THEarmpit/OSSM-Designs/README.md

# Primary project: [PitClamp v3](https://github.com/THEarmpit/OSSM-Designs/blob/main/PitClamp%20v3)

[More details for other projects coming soon]
