THEarmpit/OSSM-Designs/OSSM Remote Knobs/README.md

## OSSM Remote Knobs

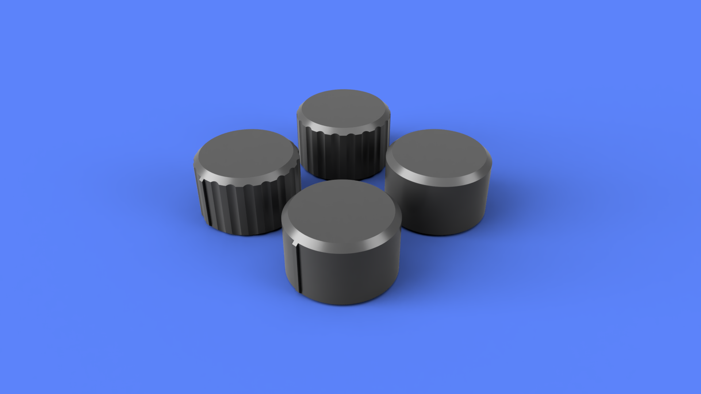
[picture p1: OSSM Remote Knobs/Images/armpit_OSSM_Remote_Knobs.png]
OSSM Remote Knobs
  

**Summary**  
Knobs that have the same overall footprint as OSSM default, but have a more minimal design providing a more easily sanitized surface and easier adjustments

- Grooved With Position Indicator  
- Grooved Simple  
- Smooth With Position Indicator  
- Smooth Simple  

**Printing**  
Print with support and with top surface ironing enabled
