THEarmpit/OSSM-Designs/Remote Mount/README.md

**To contain:**  
OSSM Remote Mount  
OSSM Remote Mount 2Part
