THEarmpit/OSSM-Designs/PitClamp v3/Base - 4040/Images/Clamped_With_Baseplate.png

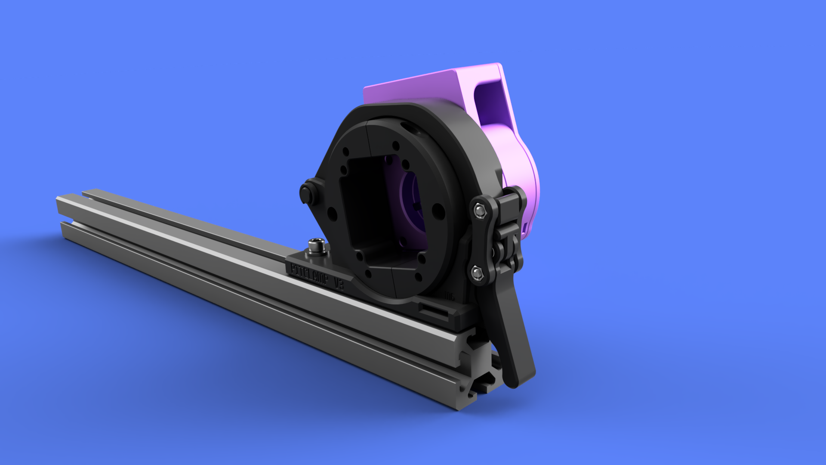
PitClamp v3/Base - 4040/Images/Clamped_With_Baseplate.png
