THEarmpit/OSSM-Designs/PitClamp v3/Base - 4040/Images/SupportSettings.png

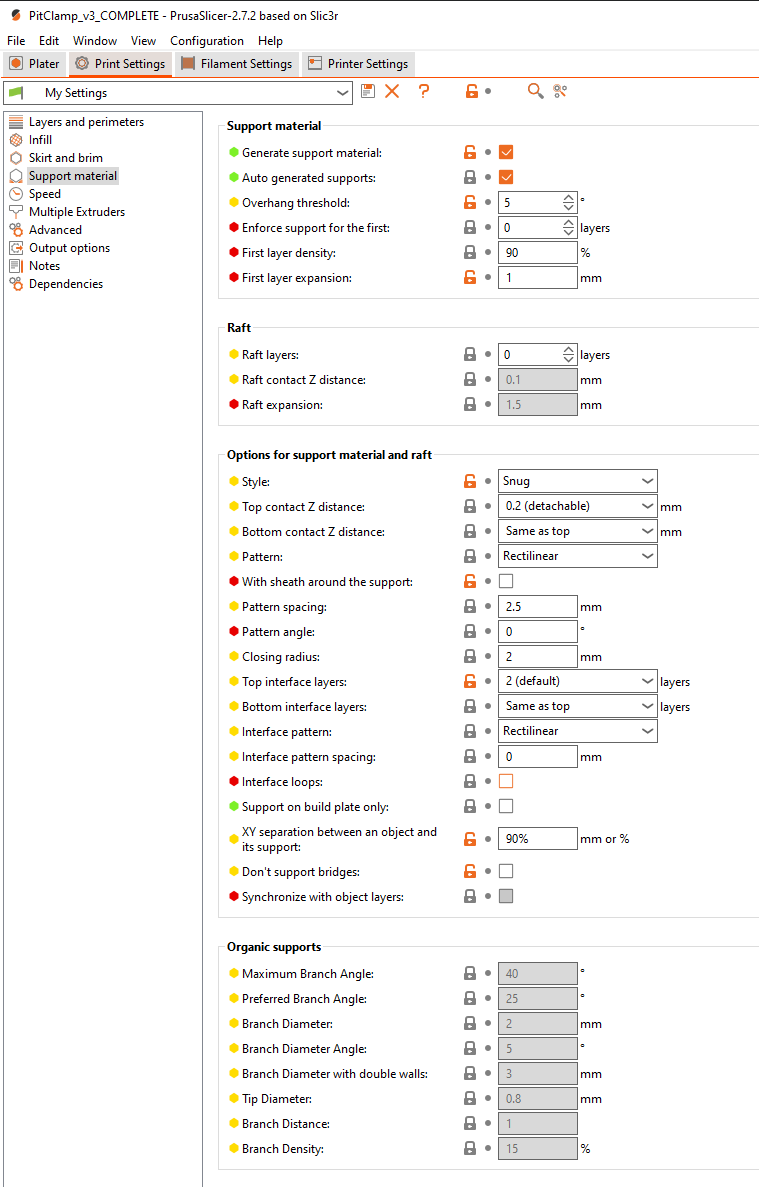
PitClamp v3/Base - 4040/Images/SupportSettings.png
