THEarmpit/OSSM-Designs/PitClamp v3/Images/PitClamp_v3_Closed_WithMotor.png

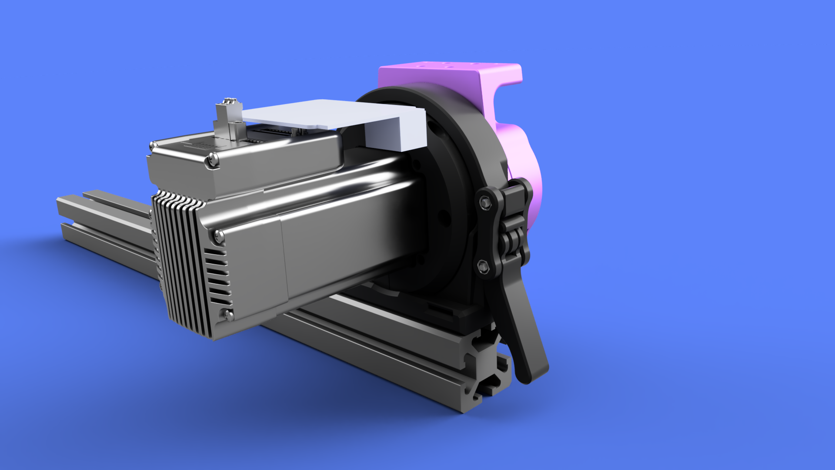
PitClamp v3/Images/PitClamp_v3_Closed_WithMotor.png
