THEarmpit/OSSM-Designs/4040 Components/README.md

**To contain:**  
Clamp Handle Lever  
Hinge Plate 210deg  
Hinge Plate 300deg  
Hinge Plate Nuts  
Mean Well GST120A24-P1M PSU Mounting Bracket  
Weight Bracket
