THEarmpit/OSSM-Designs/PitClamp v3/Base - Tabletop/Images/PitClamp_v3_Tabletop_Parts.png

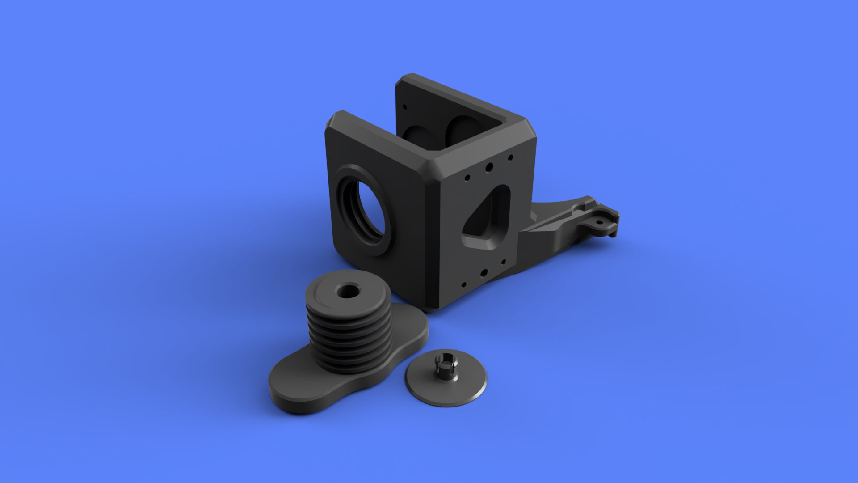
PitClamp v3/Base - Tabletop/Images/PitClamp_v3_Tabletop_Parts.png
