THEarmpit/OSSM-Designs/OSSM Reference PCB Housing With Strain Relief/Release Files/STEP/OSSM_Reference_PCB_Housing_V2_StrainRelief_Top_Reinforced_Widened_RC1.step

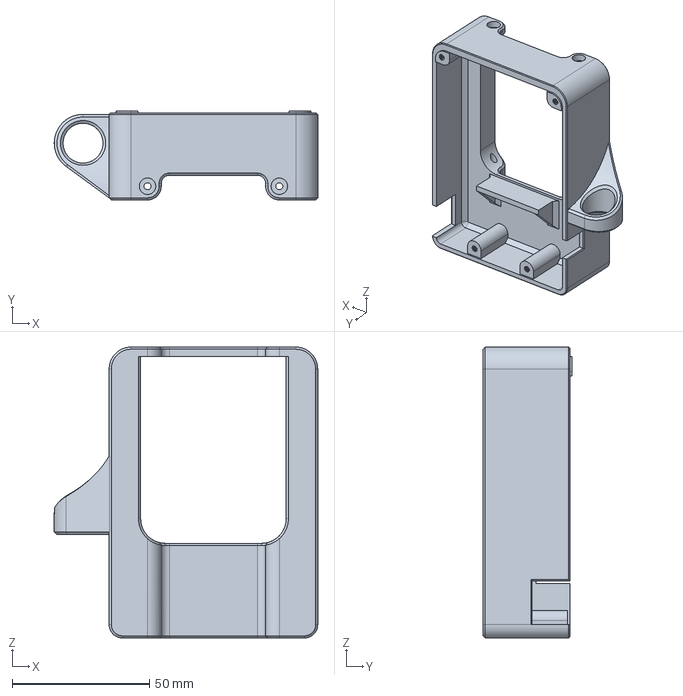
[picture p22: CAD file, 2024-06-19]
OSSM Reference PCB Housing With Strain Relief/Release Files/STEP/OSSM_Reference_PCB_Housing_V2_StrainRelief_Top_Reinforced_Widened_RC1.step
96.0 x 32.4 x 106.0 mm
