THEarmpit/OSSM-Designs/OSSM Remote Knobs/Release Files/armpit_OSSM_Remote_Knob_Smooth_With_Indicator.stl

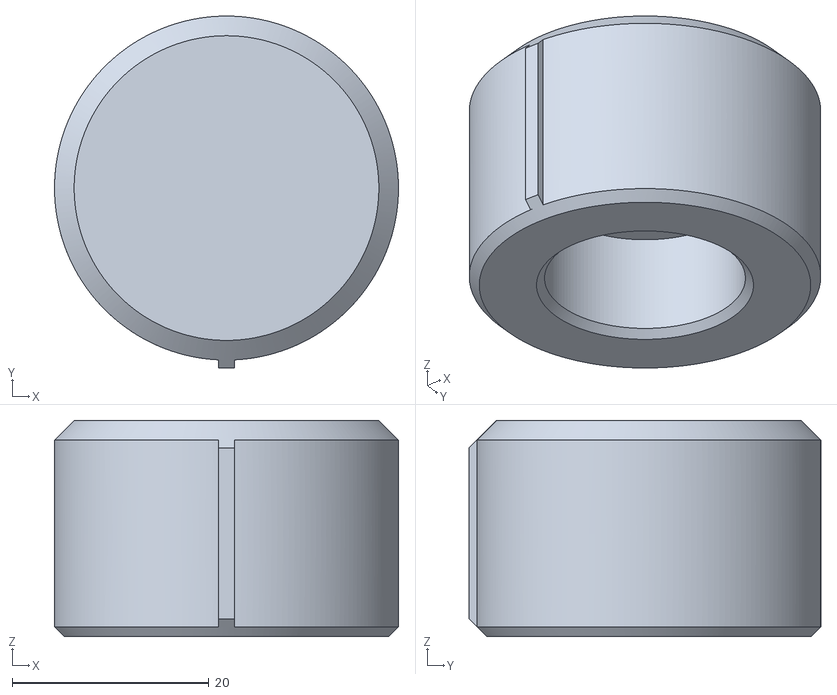
[picture p23: CAD file, 2024-06-19]
OSSM Remote Knobs/Release Files/armpit_OSSM_Remote_Knob_Smooth_With_Indicator.stl
35.0 x 35.8 x 22.0
