THEarmpit/OSSM-Designs/OSSM Remote Mount/Release Files/STEP/armpit_OSSM_Remote_Mount_2Part_Bottom.step

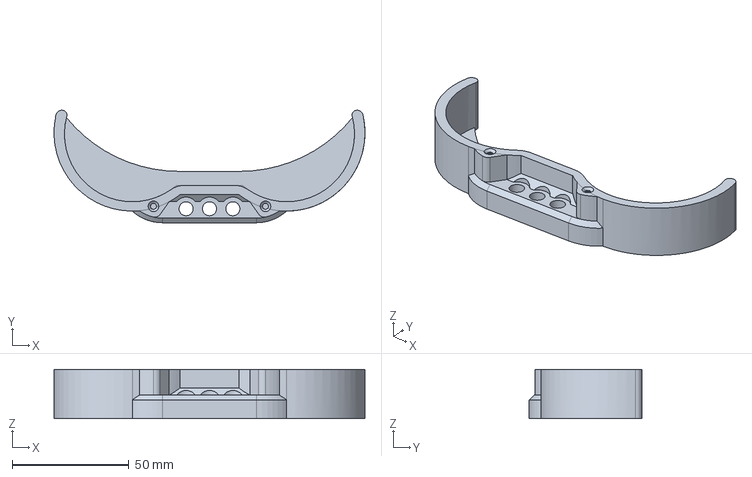
[picture p24: CAD file, 2024-06-19]
OSSM Remote Mount/Release Files/STEP/armpit_OSSM_Remote_Mount_2Part_Bottom.step
132.9 x 48.1 x 21.0 mm
