THEarmpit/OSSM-Designs/PitClamp v3/Base - 4040/Release Files/PitClamp_v3_Ring_Base_M8.stl

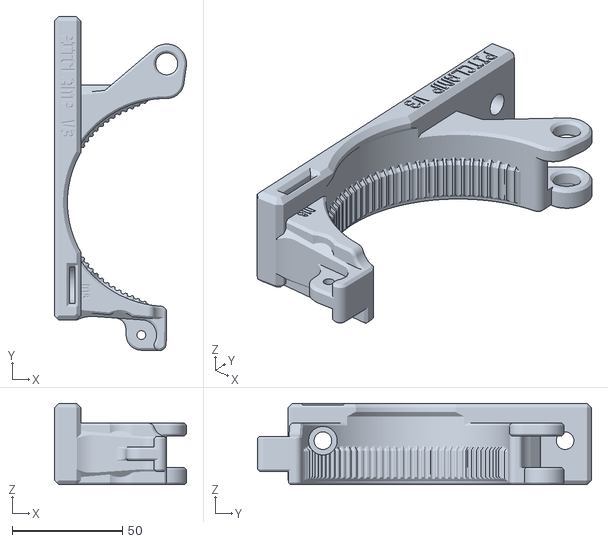
[picture p25: CAD file, 2024-03-31]
PitClamp v3/Base - 4040/Release Files/PitClamp_v3_Ring_Base_M8.stl
60.0 x 151.7 x 37.0
