THEarmpit/OSSM-Designs/PitClamp v3/Motor Rings/Release Files/STEP/PitClamp_v3_Motor_Ring_Half_EXTRAGRIP_140w.step

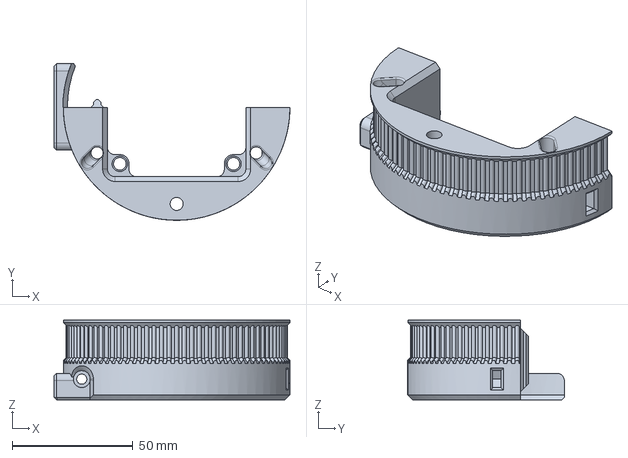
[picture p26: CAD file, 2024-04-06]
PitClamp v3/Motor Rings/Release Files/STEP/PitClamp_v3_Motor_Ring_Half_EXTRAGRIP_140w.step
97.9 x 64.9 x 33.0 mm
