THEarmpit/OSSM-Designs/PitClamp v3/Shared Components/Non-standard/20-4040/PitClamp_v3_Ring_Base_M5.stp

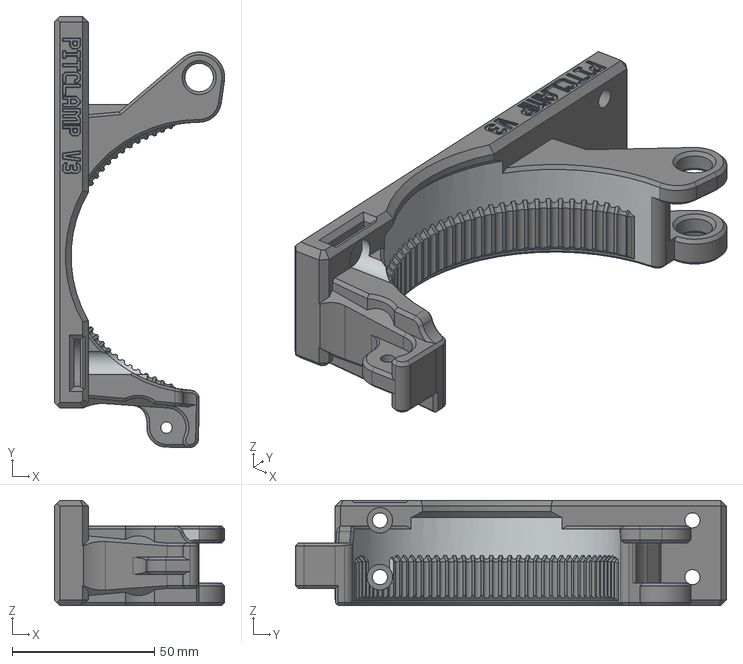
[picture p27: CAD file, 2024-04-24]
PitClamp v3/Shared Components/Non-standard/20-4040/PitClamp_v3_Ring_Base_M5.stp
60.0 x 151.7 x 37.0 mm
