THEarmpit/OSSM-Designs/PitClamp v3/Shared Components/Non-standard/dbiesn Head/PitClamp_v3_Motor_Ring_Half_EXTRAGRIP_dbiesn_head.step

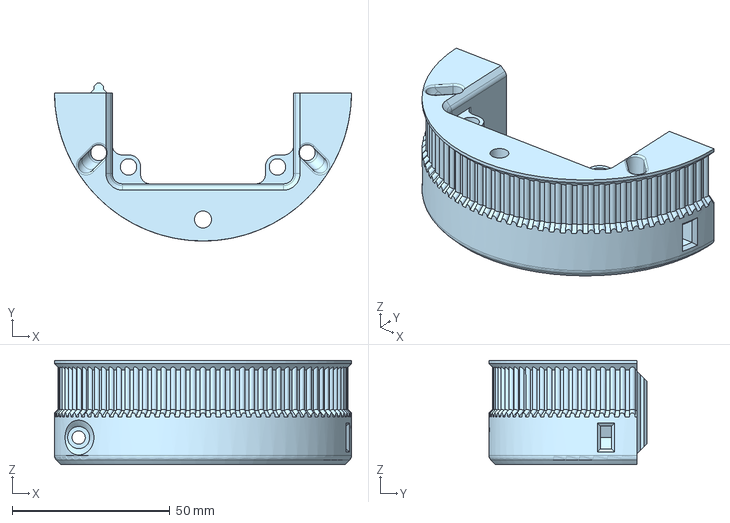
[picture p28: CAD file, 2024-04-24]
PitClamp v3/Shared Components/Non-standard/dbiesn Head/PitClamp_v3_Motor_Ring_Half_EXTRAGRIP_dbiesn_head.step
94.0 x 50.0 x 33.0 mm
