THEarmpit/OSSM-Designs/PitClamp v3/Shared Components/Non-standard/Handles/PitClamp_v3_Handle_Forward.step

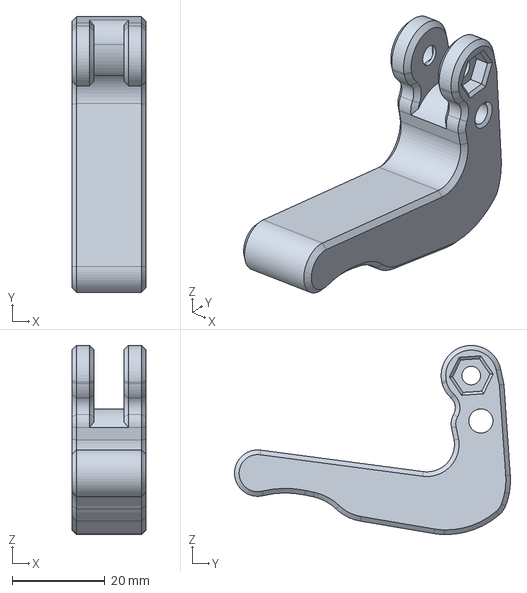
[picture p29: CAD file, 2024-04-15]
PitClamp v3/Shared Components/Non-standard/Handles/PitClamp_v3_Handle_Forward.step
16.0 x 59.5 x 40.8 mm
