THEarmpit/OSSM-Designs/PitClamp v3/Shared Components/Non-standard/Motor Ring Tighter/PitClamp_v3_Motor_Ring_Half_Tighter_Tolerances.step

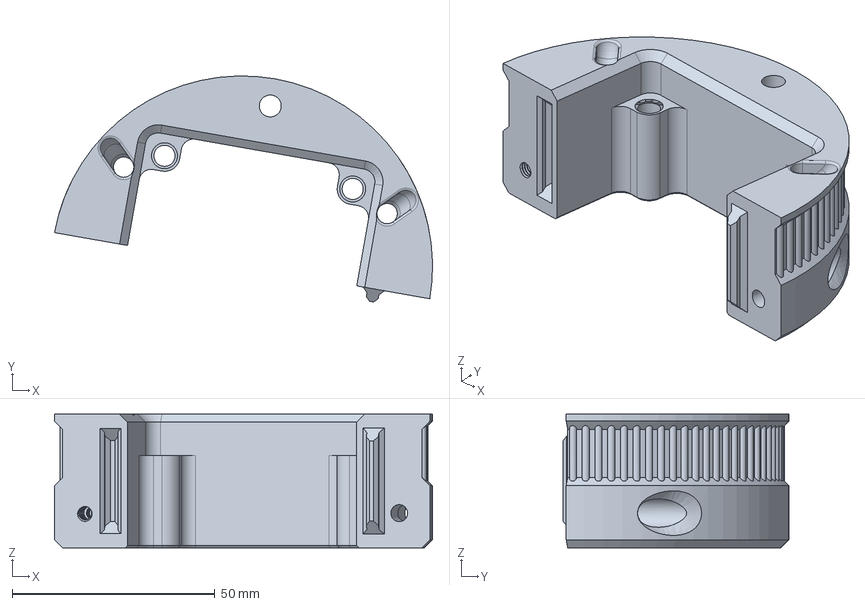
[picture p30: CAD file, 2024-05-07]
PitClamp v3/Shared Components/Non-standard/Motor Ring Tighter/PitClamp_v3_Motor_Ring_Half_Tighter_Tolerances.step
93.2 x 55.8 x 33.0 mm
