THEarmpit/OSSM-Designs/PitClamp v3/Shared Components/Non-standard/Shortened Dogbones/PitClamp_v3_Dogbone_Nuts_29mm.step

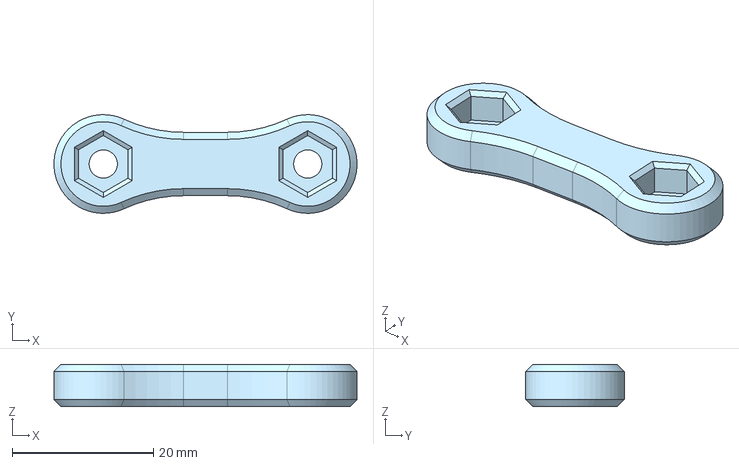
[picture p31: CAD file, 2024-04-24]
PitClamp v3/Shared Components/Non-standard/Shortened Dogbones/PitClamp_v3_Dogbone_Nuts_29mm.step
43.0 x 14.0 x 6.00 mm
