THEarmpit/OSSM-Designs/PitClamp v3/Shared Components/Release Files/PitClamp_v3_Handle_Forward.stl

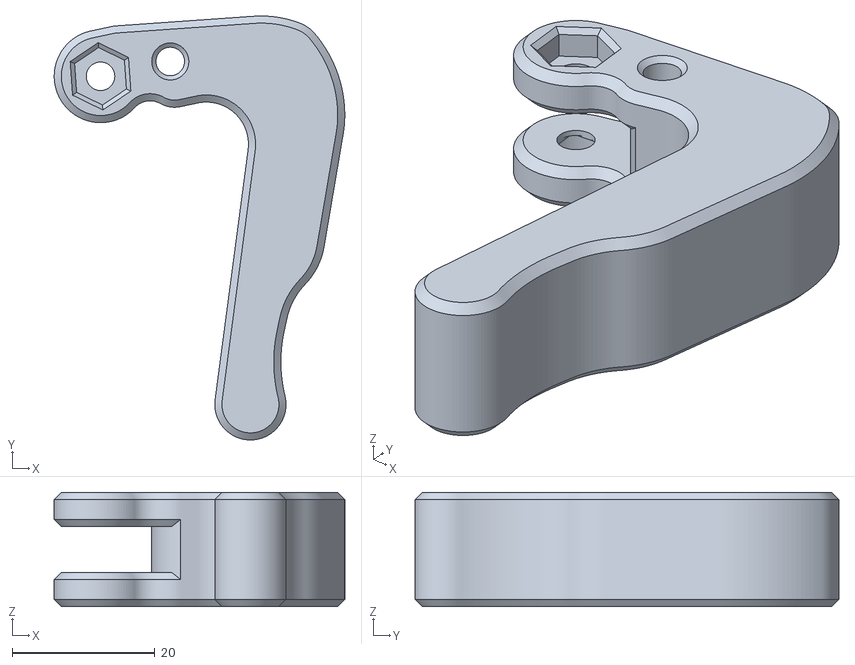
[picture p32: CAD file, 2024-04-15]
PitClamp v3/Shared Components/Release Files/PitClamp_v3_Handle_Forward.stl
40.8 x 59.5 x 16.0
