THEarmpit/OSSM-Designs/PitClamp v3/Shared Components/Release Files/STEP/PitClamp_v3_Handle.step

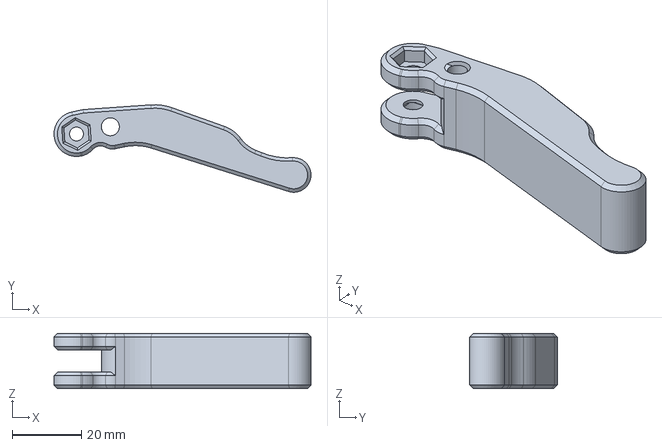
[picture p33: CAD file, 2024-03-31]
PitClamp v3/Shared Components/Release Files/STEP/PitClamp_v3_Handle.step
74.2 x 25.3 x 16.0 mm
