THEarmpit/OSSM-Designs/OSSM Remote Knobs/Release Files/armpit_OSSM_Remote_Knob_Smooth_Simple.stl

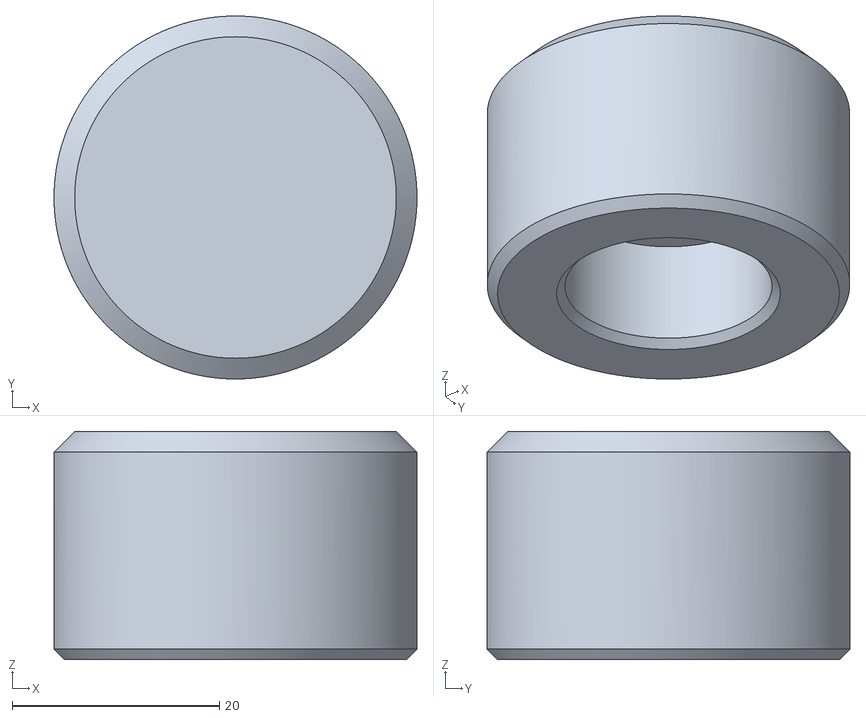
[picture p35: CAD file, 2024-06-19]
OSSM Remote Knobs/Release Files/armpit_OSSM_Remote_Knob_Smooth_Simple.stl
35.0 x 35.0 x 22.0
