THEarmpit/OSSM-Designs/OSSM Remote Mount/Release Files/STEP/armpit_OSSM_Remote_Mount_2Part_Top.step

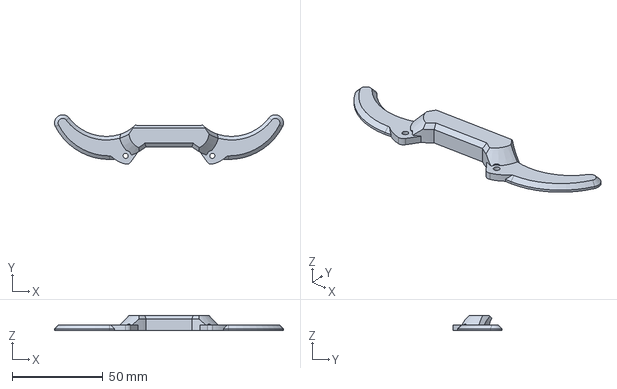
[picture p36: CAD file, 2024-06-19]
OSSM Remote Mount/Release Files/STEP/armpit_OSSM_Remote_Mount_2Part_Top.step
126.5 x 27.3 x 8.40 mm
