THEarmpit/OSSM-Designs/PitClamp v3/Shared Components/Release Files/STEP/PitClamp_v3_Hinge_Pin_Clip.step

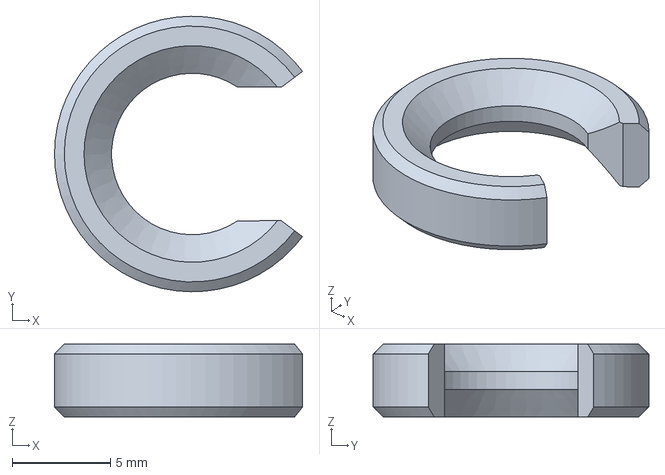
[picture p37: CAD file, 2024-03-31]
PitClamp v3/Shared Components/Release Files/STEP/PitClamp_v3_Hinge_Pin_Clip.step
12.6 x 14.0 x 3.70 mm
