THEarmpit/OSSM-Designs/PitClamp v3/Shared Components/Release Files/STEP/PitClamp_v3_Ring_Upper.step

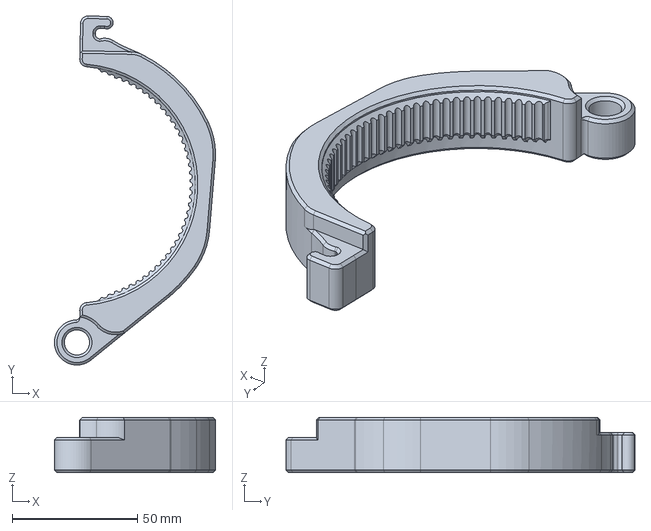
[picture p38: CAD file, 2024-03-31]
PitClamp v3/Shared Components/Release Files/STEP/PitClamp_v3_Ring_Upper.step
64.3 x 139.2 x 22.0 mm
