THEarmpit/OSSM-Designs/PitClamp v3/Shared Components/Release Files/STEP/PitClamp_v3_Dogbone_Nuts.step

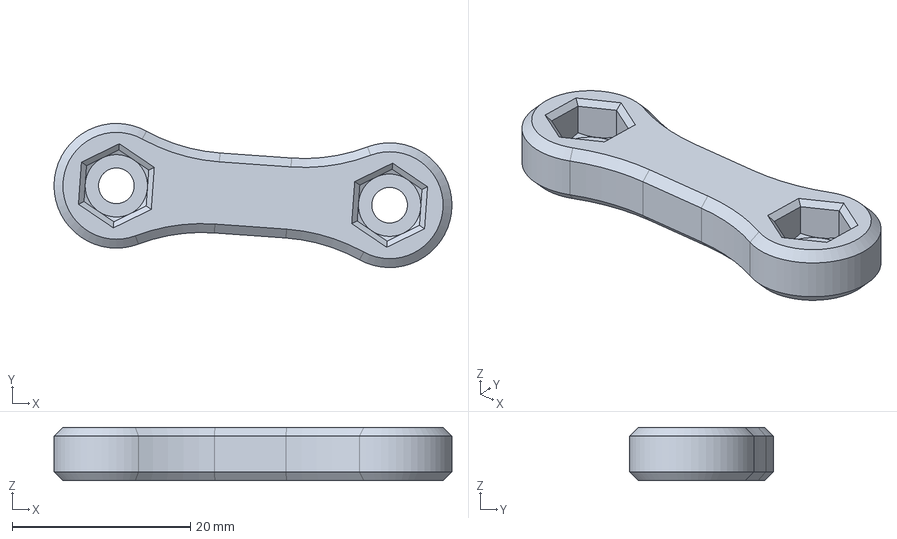
[picture p39: CAD file, 2024-03-31]
PitClamp v3/Shared Components/Release Files/STEP/PitClamp_v3_Dogbone_Nuts.step
44.7 x 16.2 x 6.00 mm
