THEarmpit/OSSM-Designs/PitClamp v3/Shared Components/Release Files/STEP/PitClamp_v3_Hinge_Pin.step

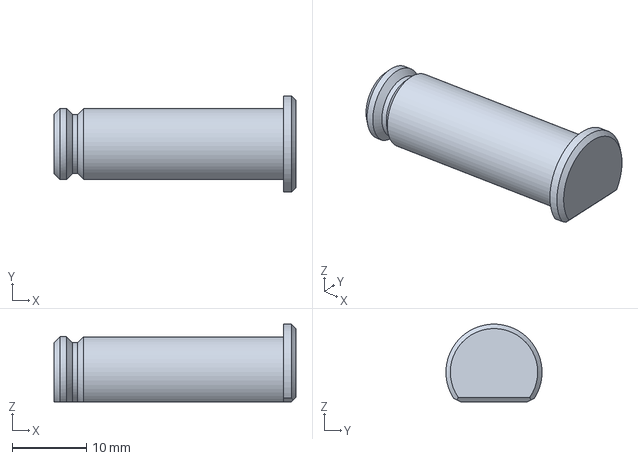
[picture p40: CAD file, 2024-03-31]
PitClamp v3/Shared Components/Release Files/STEP/PitClamp_v3_Hinge_Pin.step
32.7 x 13.0 x 10.5 mm
