THEarmpit/OSSM-Designs/(list of files, cad)

Other CAD files:
PitClamp v3/Base - 4040/Release Files/STEP/PitClamp_v3_Ring_Base_M6.step
PitClamp v3/Base - Tabletop/Release Files/STEP/PitClamp_v3_Tabletop_Mount.step
PitClamp v3/Motor Rings/Release Files/STEP/PitClamp_v3_Motor_Ring_Half_140w.step
OSSM Remote Knobs/Release Files/armpit_OSSM_Remote_Knob_Grooved_With_Indicator.stl
PitClamp v3/Motor Rings/Release Files/STEP/PitClamp_v3_Motor_Ring_Half_EXTRAGRIP.step
OSSM Remote Knobs/Release Files/armpit_OSSM_Remote_Knob_Grooved_Simple.stl
PitClamp v3/Motor Rings/Release Files/STEP/PitClamp_v3_Motor_Ring_Half.step
OSSM Reference PCB Housing With Strain Relief/Release Files/OSSM_Reference_PCB_Housing_V2_StrainRelief_Bottom_Reinforced_Widened_RC1.stl
OSSM Reference PCB Housing With Strain Relief/Release Files/OSSM_Reference_PCB_Housing_V2_StrainRelief_Top_Reinforced_Widened_RC1.stl
OSSM Remote Mount/Legacy Files/armpit_OSSM_Remote_Mount.stl
OSSM Remote Mount/Legacy Files/armpit_OSSM_Remote_Mount_Reinforced.stl.stl
OSSM Remote Mount/Release Files/armpit_OSSM_Remote_Mount_2Part_Bottom.stl
OSSM Remote Mount/Release Files/armpit_OSSM_Remote_Mount_2Part_Top.stl
PitClamp Mini/Screwcap Mini Tensioner/Release Files/STEP/Screwcap_Mini_Tensioner_Base_RC1.step
PitClamp Mini/Screwcap Mini Tensioner/Release Files/STEP/Screwcap_Mini_Tensioner_Cap_RC1.step
PitClamp Mini/Screwcap Mini Tensioner/Release Files/STEP/Screwcap_Mini_Tensioner_Ring_RC1.step
PitClamp Mini/Screwcap Mini Tensioner/Release Files/Screwcap_Mini_Tensioner_Base_RC1.stl
PitClamp Mini/Screwcap Mini Tensioner/Release Files/Screwcap_Mini_Tensioner_Cap_RC1.stl
PitClamp Mini/Screwcap Mini Tensioner/Release Files/Screwcap_Mini_Tensioner_RC1.3mf
PitClamp Mini/Screwcap Mini Tensioner/Release Files/Screwcap_Mini_Tensioner_Ring_RC1.stl
PitClamp v3/Base - 4040/Release Files/PitClamp_v3_Ring_Base_M6.stl
PitClamp v3/Base - Tabletop/Release Files/PitClamp_v3_Tabletop_Screw.stl
PitClamp v3/Base - Tabletop/Release Files/PitClamp_v3_Tabletop_Screw_Topper.stl
PitClamp v3/Base - Tabletop/Release Files/STEP/PitClamp_v3_Tabletop_Screw.step
PitClamp v3/Base - Tabletop/Release Files/STEP/PitClamp_v3_Tabletop_Screw_Topper.step
PitClamp v3/Motor Rings/Release Files/PitClamp_v3_Motor_Ring_Half.stl
PitClamp v3/Motor Rings/Release Files/PitClamp_v3_Motor_Ring_Half_140w.stl
PitClamp v3/Motor Rings/Release Files/PitClamp_v3_Motor_Ring_Half_EXTRAGRIP.stl
PitClamp v3/Motor Rings/Release Files/PitClamp_v3_Motor_Ring_Half_EXTRAGRIP_140w.stl
PitClamp v3/Shared Components/Non-standard/20-4040/PitClamp_v3_Ring_Base_M5.stl
PitClamp v3/Shared Components/Non-standard/Motor Ring Tighter/PitClamp_v3_Motor_Ring_Half_Tighter_Tolerances.stl
PitClamp v3/Shared Components/Non-standard/Shortened Dogbones/PitClamp_v3_Dogbone_Bolts_29mm.step
PitClamp v3/Shared Components/Release Files/PitClamp_V3_Ring_Upper.stl
PitClamp v3/Shared Components/Release Files/PitClamp_v3_Dogbone_Bolts.stl
PitClamp v3/Shared Components/Release Files/PitClamp_v3_Dogbone_Nuts.stl
PitClamp v3/Shared Components/Release Files/PitClamp_v3_Handle.stl
PitClamp v3/Shared Components/Release Files/PitClamp_v3_Hinge_Pin.stl
PitClamp v3/Shared Components/Release Files/PitClamp_v3_Hinge_Pin_Clip.stl
PitClamp v3/Shared Components/Release Files/STEP/PitClamp_v3_Dogbone_Bolts.step
