THEarmpit/OSSM-Designs/(commit log)

2024-03-31 Rename PitClamp v3/Base - 4040/Clamped_With_Baseplate.png to PitClamp v3/Base - 4040/Images/Clamped_With_Baseplate.png
2024-03-31 Rename PitClamp v3/Base - Tabletop/PitClamp_v3_Tabletop_Mount.step to PitClamp v3/Base - Tabletop/STEP/PitClamp_v3_Tabletop_Mount.step
    [PitClamp_v3_Tabletop_Mount.step]
2024-03-31 Update and rename PitClamp v3/Base - Tabletop/PitClamp_v3_Tabletop_Screw.step to PitClamp v3/Base - Tabletop/STEP/PitClamp_v3_Tabletop_Screw.step
    [PitClamp_v3_Tabletop_Screw.step]
2024-03-31 Update and rename PitClamp v3/Base - Tabletop/PitClamp_v3_Tabletop_Screw_Topper.step to PitClamp v3/Base - Tabletop/STEP/PitClamp_v3_Tabletop_Screw_Topper.step
    [PitClamp_v3_Tabletop_Screw_Topper.step]
2024-03-31 Update and rename PitClamp v3/Base - 4040/PitClamp_v3_Ring_Base_M6.step to PitClamp v3/Base - 4040/STEP/PitClamp_v3_Ring_Base_M6.step
    [PitClamp_v3_Ring_Base_M6.step]
2024-03-31 Rename PitClamp v3/Base - 4040/PitClamp_v3_Ring_Base_M8.step to PitClamp v3/Base - 4040/STEP/PitClamp_v3_Ring_Base_M8.step
    [PitClamp_v3_Ring_Base_M8.step]
2024-03-31 Update and rename PitClamp v3/Motor Rings/PitClamp_v3_Motor_Ring_Half.step to PitClamp v3/Motor Rings/STEP/PitClamp_v3_Motor_Ring_Half.step
    [PitClamp_v3_Motor_Ring_Half.step]
2024-03-31 Update and rename PitClamp v3/Motor Rings/PitClamp_v3_Motor_Ring_Half_140w.step to PitClamp v3/Motor Rings/STEP/PitClamp_v3_Motor_Ring_Half_140w.step
    [PitClamp_v3_Motor_Ring_Half_140w.step]
2024-03-31 Update and rename PitClamp v3/Motor Rings/PitClamp_v3_Motor_Ring_Half_EXTRAGRIP.step to PitClamp v3/Motor Rings/STEP/PitClamp_v3_Motor_Ring_Half_EXTRAGRIP.step
    [PitClamp_v3_Motor_Ring_Half_EXTRAGRIP.step]
2024-03-31 Update and rename PitClamp v3/Motor Rings/PitClamp_v3_Motor_Ring_Half_EXTRAGRIP_140w.step to PitClamp v3/Motor Rings/STEP/PitClamp_v3_Motor_Ring_Half_EXTRAGRIP_140w.step
    [PitClamp_v3_Motor_Ring_Half_EXTRAGRIP_140w.step]
2024-03-31 Rename PitClamp v3/Shared Components/Assembly_View.png to PitClamp v3/Shared Components/Images/Assembly_View.png
2024-03-31 Update and rename PitClamp v3/Shared Components/PitClamp_v3_Ring_Upper.step to PitClamp v3/Shared Components/STEP/PitClamp_v3_Ring_Upper.step
    [PitClamp_v3_Ring_Upper.step]
2024-03-31 Update and rename PitClamp v3/Shared Components/PitClamp_v3_Hinge_Pin_Clip.step to PitClamp v3/Shared Components/STEP/PitClamp_v3_Hinge_Pin_Clip.step
    [PitClamp_v3_Hinge_Pin_Clip.step]
2024-03-31 Update and rename PitClamp v3/Shared Components/PitClamp_v3_Hinge_Pin.step to PitClamp v3/Shared Components/STEP/PitClamp_v3_Hinge_Pin.step
    [PitClamp_v3_Hinge_Pin.step]
2024-03-31 Update and rename PitClamp v3/Shared Components/PitClamp_v3_Handle.step to PitClamp v3/Shared Components/STEP/PitClamp_v3_Handle.step
    [PitClamp_v3_Handle.step]
2024-03-31 Update and rename PitClamp v3/Shared Components/PitClamp_v3_Dogbone_Nuts.step to PitClamp v3/Shared Components/STEP/PitClamp_v3_Dogbone_Nuts.step
    [PitClamp_v3_Dogbone_Nuts.step]
2024-03-31 Update and rename PitClamp v3/Shared Components/PitClamp_v3_Dogbone_Bolts.step to PitClamp v3/Shared Components/STEP/PitClamp_v3_Dogbone_Bolts.step
    [PitClamp_v3_Dogbone_Bolts.step]
2024-03-31 Rename PitClamp v3/Motor Rings/Assembly_View_Motor_Rings.png to PitClamp v3/Motor Rings/STEP/Assembly_View_Motor_Rings.png
2024-03-31 Rename PitClamp v3/Motor Rings/STEP/Assembly_View_Motor_Rings.png to PitClamp v3/Motor Rings/STEP/Images/Assembly_View_Motor_Rings.png
2024-03-31 Rename PitClamp v3/Motor Rings/STEP/Images/Assembly_View_Motor_Rings.png to PitClamp v3/Motor Rings/Images/Assembly_View_Motor_Rings.png
2024-04-06 Increased ring M5 hole by .5mm for better fit
    [PitClamp_v3_Motor_Ring_Half.stl, PitClamp_v3_Motor_Ring_Half_140w.stl, PitClamp_v3_Motor_Ring_Half_EXTRAGRIP.stl, PitClamp_v3_Motor_Ring_Half_EXTRAGRIP_140w.stl]
2024-04-06 Update README.md
    M5 mounting to OSSM Base is required, not optional
2024-04-15 Adding PitClamp_v3_Handle_Forward files
    [PitClamp_v3_Handle_Forward.step, PitClamp_v3_Handle_Forward.stl]
2024-04-15 Adding non-standard PitClamp v3 Handle files
    [PitClamp_v3_Handle_Forward.step, PitClamp_v3_Handle_Forward.stl]
2024-04-15 PitClamp v3 Tabletop Base Release Candidate 2
    Fixes minor hinge slicer issue found in PrusaSlicer and BambuSlicer
2024-04-15 STEP for Release Candidate 2
    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
2024-04-24 Update and rename PitClamp v3/Shared Components/Non-standard/PitClamp_v3_Handle_Forward.step to PitClamp v3/Shared Components/Non-standard/Handles/PitClamp_v3_Handle_Forward.step
    [PitClamp_v3_Handle_Forward.step]
2024-04-24 Rename PitClamp v3/Shared Components/Non-standard/PitClamp_v3_Handle_Forward.stl to PitClamp v3/Shared Components/Non-standard/Handles/PitClamp_v3_Handle_Forward.stl
    [PitClamp_v3_Handle_Forward.stl]
2024-05-07 Horizontal slop reduced to .2mm from 1mm
    [PitClamp_v3_Motor_Ring_Half_Tighter_Tolerances.step, PitClamp_v3_Motor_Ring_Half_Tighter_Tolerances.stl]
2024-06-19 Add Screwcap Mini Tensioner RC1
    [Screwcap_Mini_Tensioner_Base_RC1.step, Screwcap_Mini_Tensioner_Base_RC1.stl, Screwcap_Mini_Tensioner_Cap_RC1.step, Screwcap_Mini_Tensioner_Cap_RC1.stl, Screwcap_Mini_Tensioner_RC1.3mf, Screwcap_Mini_Tensioner_Ring_RC1.step, Screwcap_Mini_Tensioner_Ring_RC1.stl]
2024-06-19 Update README.md
    Add images to Screwcap Mini Tensioner README
2024-06-19 Add release files for OSSM Reference PCB Housing Strain Relief
    [OSSM_Reference_PCB_Housing_V2_StrainRelief_Bottom_Reinforced_Widened_RC1.step, OSSM_Reference_PCB_Housing_V2_StrainRelief_Bottom_Reinforced_Widened_RC1.stl, OSSM_Reference_PCB_Housing_V2_StrainRelief_Top_Reinforced_Widened_RC1.step, OSSM_Reference_PCB_Housing_V2_StrainRelief_Top_Reinforced_Widened_RC1.stl]
2024-06-19 Update release folder consistency
    [PitClamp_v3_Ring_Base_M6.step, PitClamp_v3_Ring_Base_M6.stl, PitClamp_v3_Ring_Base_M8.step, PitClamp_v3_Ring_Base_M8.stl]
2024-06-19 Update release folder structure consistency
    [Screwcap_Mini_Tensioner_Base_RC1.step, Screwcap_Mini_Tensioner_Base_RC1.stl, Screwcap_Mini_Tensioner_Cap_RC1.step, Screwcap_Mini_Tensioner_Cap_RC1.stl, Screwcap_Mini_Tensioner_RC1.3mf, Screwcap_Mini_Tensioner_Ring_RC1.step, Screwcap_Mini_Tensioner_Ring_RC1.stl]
2024-06-19 Add OSSM Remote Mount Release
    [armpit_OSSM_Remote_Mount.stl, armpit_OSSM_Remote_Mount_2Part_Bottom.stl, armpit_OSSM_Remote_Mount_2Part_Top.stl, armpit_OSSM_Remote_Mount_Reinforced.stl.stl]
2024-06-19 Add STEP files
    [armpit_OSSM_Remote_Mount_2Part_Bottom.step, armpit_OSSM_Remote_Mount_2Part_Top.step]
2024-06-19 Add OSSM Remote Knobs release
    [armpit_OSSM_Remote_Knob_Grooved_Simple.stl, armpit_OSSM_Remote_Knob_Grooved_With_Indicator.stl, armpit_OSSM_Remote_Knob_Smooth_Simple.stl, armpit_OSSM_Remote_Knob_Smooth_With_Indicator.stl]
